Superbbbbbb/HUST-Project-of-Hardware-System/(list of files, drawings)

Other design files:
cpu21-riscv/cpu21-riscv.circ
cpu21-riscv/中断信号测试模拟电路.circ
cpu21-riscv/中断按键信号产生.circ
