Superbbbbbb/HUST-Project-of-Hardware-System/cpu21-riscv-verilog/sources_1/imports/verilog/memory/ROM_ROM.v

`timescale 1ns/1ps

module ROM( Address, Data);

   input[9:0]  Address;
   output reg[31:0] Data;

   always @ (Address)
   begin
      case(Address)
         0 : Data = 1049747;
         1 : Data = 16777327;
         2 : Data = 1049747;
         3 : Data = 2099475;
         4 : Data = 3148179;
         5 : Data = 16777327;
         6 : Data = 1049747;
         7 : Data = 2099475;
         8 : Data = 3148179;
         9 : Data = 16777327;
         10 : Data = 1049747;
         11 : Data = 2099475;
         12 : Data = 3148179;
         13 : Data = 16777327;
         14 : Data = 1049747;
         15 : Data = 2099475;
         16 : Data = 3148179;
         17 : Data = 1023410415;
         18 : Data = 1049619;
         19 : Data = 1049747;
         20 : Data = 32806035;
         21 : Data = 9438515;
         22 : Data = 35653779;
         23 : Data = 115;
         24 : Data = 2413715;
         25 : Data = 296035;
         26 : Data = -18878353;
         27 : Data = 9438515;
         28 : Data = 35653779;
         29 : Data = 115;
         30 : Data = 1049747;
         31 : Data = 2397331;
         32 : Data = 9438515;
         33 : Data = 35653779;
         34 : Data = 115;
         35 : Data = 296035;
         36 : Data = -18878353;
         37 : Data = 1049747;
         38 : Data = 32806035;
         39 : Data = 9438515;
         40 : Data = 35653779;
         41 : Data = 115;
         42 : Data = 1077204115;
         43 : Data = 9438515;
         44 : Data = 35653779;
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
         279 : Data = 8389939;
         280 : Data = 35653779;
         281 : Data = 115;
         282 : Data = 6554643;
         283 : Data = 8389939;
         284 : Data = 35653779;
         285 : Data = 115;
         286 : Data = 7603219;
         287 : Data = 8389939;
         288 : Data = 35653779;
         289 : Data = 115;
         290 : Data = 8651795;
         291 : Data = 8389939;
         292 : Data = 35653779;
         293 : Data = 35653779;
         294 : Data = 115;
         295 : Data = 32871;
         default : Data = 0;
      endcase
   end

endmodule
