Superbbbbbb/HUST-Project-of-Hardware-System/cpu21-riscv-verilog/sources_1/new/decoder.v

`timescale 1ns / 1ps

module decoder(num, sel);
    input [2: 0] num;       // 数码管编号：0~7
    output reg [7:0] sel;       // 7段数码管片选信号，低电平有效
    always@(num)  begin
        case(num[2:0]) 
            3'b000 : sel[7:0] = 8'b11111110;
            3'b001 : sel[7:0] = 8'b11111101;
            3'b010 : sel[7:0] = 8'b11111011;
            3'b011 : sel[7:0] = 8'b11110111;
            3'b100 : sel[7:0] = 8'b11101111;
            3'b101 : sel[7:0] = 8'b11011111;
            3'b110 : sel[7:0] = 8'b10111111;
            3'b111 : sel[7:0] = 8'b01111111;
        endcase
    end
endmodule
